3s1d/fanet-stm32/README.md

# FANET
Flying Ad-hoc Network 

# IDE
Use SW4SRTM32

# Protocol
[Brief specification](https://github.com/3s1d/fanet-stm32/blob/master/Src/fanet/radio/protocol.txt)

# Documentation
[Module (PDF)](https://github.com/3s1d/fanet-stm32/raw/master/fanet_module.pdf)
