3s1d/fanet-stm32/(threads)

Thread 3 (2018-01-06):

fanet Bodenstation

wysi, 2018-01-06:
Guten Tag

Vielen Dank, dass du/ihr/skytraxx euch dafür entschieden habt, fanet opensource zu machen.
Mir ist bekannt, dass skytraxx im Sommer einen fanet Bodenstation herausgeben wird.

Mich würde folgendes zum Thema Bodenstation interessieren:

Ist vorgesehen, dass darüber neben Wetterdaten auch die Daten von open glider net über fanet and die skytraxx Geräte gesendet werden?
Damit kann man umgehen, dass eine Mobilfunkverbindung/Wifi Hotspot benötigt wird um die Daten von Nicht-Fanet Geräten auf dem skytraxx anzuzeigen.

Ich stelle mir vor, dass ich z.B. mit einem Raspberry Pi als Bodenstation die ONG Datenbank nach Einträgen im Umkreis von einigen Kilometern scanne und die Daten von Nicht-Fanet Geräten (Reine FLARM, Segelflieger, Flugzeuge) über ein LoRa Modul und das Fanet Protokoll an die skytraxx Geräte sende.

Diese skytraxx Geräte hätten somit alle ONG Daten ohne direkt Mobilfunkverbindung/Internet auf dem Bildschirm.

3s1d, 2018-01-09:
Hallo wysi,

dein Vorschalg schwebt mir auch schon laenger im Kopf herum. Theoretisch waere es moeglich und ich wuerde das Protokoll dementsprechend erweitern wenn es umgesetzt werden soll.

Derzeit bin ich am kaempfen das Basisstationen FANET daten an OGN Server, also so wie ein Skytraxx 3.0 mit WLAN, weiterleiten. Da wir nicht alles alleine machen wollen versuche ich moeglichst viele Partner ins Boot zu holen und diese gilt es zunaechst zu ueberzeugen.

Viele Gruesse
Juergen

TL;DR: Theoretisch ja, prakitsch wird es noch etwas dauern.

Closed 2018-01-09.

Thread 4 (2018-04-26):

Beacons to OGN aprs servers

Meisterschueler, 2018-04-26:
We can see these beacons from fanet devices:

```
FNTFF00BD>OGNFNT,qAS,FNBFF00BD:/182547h3820.71N/00028.78Wg295/000/A=000043 !W74! id1FFF00BD -04fpm
FNBFF00BD>OGNFNT,TCPIP*,qAC,GLIDERN2:/182547h3820.72NI00028.78E&/A=000043
FNTFF00BD>OGNFNT,qAS,FNBFF00BD:/182547h3820.71N/00028.78Wg295/000/A=000043 !W74! id1FFF00BD +03fpm
FNTFF00BD>OGNFNT,qAS,FNBFF00BD:/182547h3820.71N/00028.78Wg295/000/A=000043 !W74! id1FFF00BD -01fpm
FNTFF00BD>OGNFNT,qAS,FNBFF00BD:/182547h3820.71N/00028.78Wg295/000/A=000043 !W74! id1FFF00BD -03fpm
FNBFF00BD>OGNFNT,TCPIP*,qAC,GLIDERN2:/182547h3820.72NI00028.78E&/A=000043
FNTFF00BD>OGNFNT,qAS,FNBFF00BD:/182547h3820.71N/00028.78Wg295/000/A=000043 !W74! id1FFF00BD +03fpm
FNTFF00BD>OGNFNT,qAS,FNBFF00BD:/182547h3820.71N/00028.78Wg295/000/A=000042 !W74! id1FFF00BD +01fpm
FNTFF00BD>OGNFNT,qAS,FNBFF00BD:/182547h3820.71N/00028.78Wg295/000/A=000042 !W74! id1FFF00BD -06fpm
FNBFF00BD>OGNFNT,TCPIP*,qAC,GLIDERN2:/182547h3820.72NI00028.78E&/A=000043
FNTFF00BD>OGNFNT,qAS,FNBFF00BD:/182547h3820.71N/00028.78Wg295/000/A=000043 !W74! id1FFF00BD -01fpm
FNTFF00BD>OGNFNT,qAS,FNBFF00BD:/182547h3820.71N/00028.78Wg295/000/A=000043 !W74! id1FFF00BD +01fpm
FNTFF00BD>OGNFNT,qAS,FNBFF00BD:/182547h3820.71N/00028.78Wg295/000/A=000043 !W74! id1FFF00BD -00fpm
FNBFF00BD>OGNFNT,TCPIP*,qAC,GLIDERN2:/182547h3820.72NI00028.78E&/A=000042
FNTFF00BD>OGNFNT,qAS,FNBFF00BD:/182547h3820.71N/00028.78Wg295/000/A=000043 !W74! id1FFF00BD +02fpm
FNTFF00BD>OGNFNT,qAS,FNBFF00BD:/182547h3820.71N/00028.78Wg295/000/A=000043 !W74! id1FFF00BD +06fpm
FNTFF00BD>OGNFNT,qAS,FNBFF00BD:/182547h3820.71N/00028.78Wg295/000/A=000043 !W74! id1FFF00BD +01fpm
FNBFF00BD>OGNFNT,TCPIP*,qAC,GLIDERN2:/182547h3820.72NI00028.78E&/A=000043
FNTFF00BD>OGNFNT,qAS,FNBFF00BD:/182547h3820.71N/00028.78Wg295/000/A=000043 !W74! id1FFF00BD -04fpm
FNTFF00BD>OGNFNT,qAS,FNBFF00BD:/182547h3820.71N/00028.78Wg295/000/A=000043 !W74! id1FFF00BD -05fpm
```

My thoughts:

1. a device should send informations only once per timestamp. Multiple beacons with same timestamp and different climb rate seems invalid. One information per timestamp means: one beacon or beacons with different types (e.g. position beacon + status beacon as the tracker does).
2. we see "two devices". The device "FNB" is a "receiver" sending beacons to GLIDERN2, the device "FNT" is the aircraft and it is received by the "FNB". Both have the same dstcall. This behaviour is distantly related to the APRS beacons for <= 0.2.6. But: the "receiver" beacon is just a subset of the "aircraft" beacon.

My idea: the FNT behaviour should be the same as the naviter beacons:

- no more FNTxxxxxx>OGNFNT,qAS,FNBxxxxxx:/blabla since it is the same device
 ... but a FNTxxxxxx>OGNFNT,qAS,GLIDERN1:/blabla --> for beacons from the "device"
 ... and FNTyyyyyy>OGNFNT,FNTxxxxxx*,qAS,GLIDERN1:/blabla --> for device yyyyyy seen and relayed by the device xxxxxx
- no more FNB beacons since they are quite useless beside the FNT beacons (correct me if I am wrong)
 ... but a FNTxxxx>OGNFNT,qAS,GLIDERN1:>blabla --> status beacon with information about the skytraxx software or something like this

3s1d, 2018-05-01:
This is not an FANET related issue. The device in question does not even have an FANET model build in (see ID FFxxxx). It's a Skytraxx 3.0 w/ WiFi. Please tell me your mail address or contact me via my Skytraxx contact.

In short:
As during the time of development there was no way to add other devices than OGN/FLARM. The 'naviter interface' was not present back than. I tried to expend the interface but nobody from OGN reacted on my request. So I botched I'net connected devices and FANET devices in! Here the base station is only emulated as it is required to get displayed on glidertracker.de (w/o a base station they do not display anything). In case of a real FANET devices it is really a flying base station which will forward any other FANET node to the OGN servers. So it's mandatory in that cases. I'd be happy to change the protocol to a suitable modern one, but i won't do it every 6month (got other things to do).

During none-flight mode the position should be reported every 20sec and the base station gets updated every 60sec. So the 3 to 1 line ratio is correct. The constant time may be a GPS-fix related bug which I have to check.

Cheers
Juergen

Closed 2018-05-01.

Thread 10 (2020-05-15):

response

z983889767, 2020-05-15:
Hello, I'm a student. I'm learning fanet recently, so I want to know what routing protocol your code adopts. If you know ，please tell me. I would be grateful

3s1d, 2020-05-27:
Hi,
as said, there is currently no routing other then a decision table based 1-hop forwarding. Well fanet-base has a geo fence based forwarding as well. However I won't call one for them routing in the classical sense.

Juergen

Thread 12 (2021-04-17):

request contact to implement fanet protocol

DRIZO, 2021-04-17:
Hello Juergen,
What is the correct way to contact with you or fanet protocol developer?
I interested on implementation of fanet protocol in our devices.
Thanks

3s1d, 2021-04-17:
Hi Drizo,

you can ask me anything here, or use my mail address:
[secondWordOfYourText-aka-myFirstName] [at] skytraxx [dot] eu

Cheers,
Juergen

Thread 14 (2022-01-07):

915Mhz Question

Tokter, 2022-01-07:
What are the plans for FANET outside of Europe?

On the Skytraxx 2.1 product page (https://en.skytraxx.eu/product-page/skytraxx-2-1) it states:

_FANET and FLARM broadcast on 868Mhz. Outside the EU, FANET must be deactivated.
The frequency is also planned to be expanded to 915Mhz for 2020._

The Skytraxx 4.0 product page does not mention anything about frequencies yet.

I know there are other vario manufacturers that use your module to provide the Fanet/Flarm functionality, which then in turn have the same limitation of only working/be legal in Europe. Without explaining that limitation as transparently on their websites.

Is there any hope for people like me that would need the 915MHz option, or is that market just too small to bother?

Thanks,
Markus

3s1d, 2022-01-23:
Hi,
well... Covid happened. We still plan to enable 9xxMhz for FANET. It's very import to us. However, due to the chip shortage and so on, we currently do not have time to figure out all the 'little' details for each country (like: frequency, power, bandwidth, duty cycle, and many more).  If you can provide a list or anything else this would greatly boost the development. Thanks,
Juergen

Tokter, 2022-01-24:
I'm not an expert in that, but I tried to gather at least some of the relevant information. Thanks for the update!

# US

## Frequency spectrum
902Mhz - 928MHz

## Bandwidth
I think you're using 250kHz, so this applies:
_if the 20 dB bandwidth of the hopping channel is 250 kHz or greater, the system shall use at least 25 hopping frequencies_

## Duty Cycle
For 250kHz bandwidth, this applies:
_the average time of occupancy on any frequency shall not be greater than 0.4 seconds within a 10 second period._

## Power
_0.25 watts for systems employing less than 50 hopping channels, but at least 25 hopping channels_

This assumes an antenna with no more than 6dBi gain:
 _The conducted output power limit specified in paragraph (b) of this section is based on the use of antennas
with directional gains that do not exceed 6 dBi. Except as shown in paragraph (c) of this section, if transmitting antennas of directional gain greater than 6 dBi are used, the conducted output power from the intentional radiator shall be reduced below the stated values in paragraphs (b)(1), (b)(2), and (b)(3) of this section, as appropriate, by the amount in dB that the
directional gain of the antenna exceeds 6 dBi_

## Links
Regulation: https://www.govinfo.gov/content/pkg/CFR-2013-title47-vol1/pdf/CFR-2013-title47-vol1-sec15-247.pdf
ISM-Band and Short Range Device Regulatory Compliance Overview: https://www.ti.com/lit/an/swra048/swra048.pdf

3s1d, 2022-02-20:
Hi,

thanks for the information. Guess I have to start somewhere...

As I recall it correctly there is some kind of threshold were one does not need to do frequency hopping, right?! I'd hate to implement this. Specially for devices w/o GPS this is not simple... (This is the only thing currently holding me back.)

Right now the duty cycle is below 1%, all antenna gains are <4dBi, and we are transmitting with 14dBm (25mW). Do I recall it correctly that we'd simple would have to increase the used bandwidth to >250kHz and then we are fine?

Can you implement the driver? Do you want to do testing, as it's not legal in my area :)
What kind of device are you using?  -> Contact me via mail.

Juergen

ifrew, 2022-03-30:
Hi Jurgen,

Hope you are doing well. This is Iain from Seattle. I worked with Phil on the Airwhere project, met with you at Kossen and have since developed my little vario and fanet device to a fully functional working prototype based on esp32. I thought i'd update the old fanet software I ported from your original code to the latest version you have here and so came across this comment. I investigated getting my device certified over here and contacted a lab that could do FCC testing in Chicago. Cost was around $10,000 so pretty spendy. However, I gleamed some good information from them. You do not need to implement frequency hopping I'm glad to report as long as you use a frequency bandwidth of 500Khz. I was surprised by this but they assured me that would be legal. They also wouldn't do frequency hopping tests for me due to the test equipment they would need to setup as the market for using that is so small. So currently I use as my parameters over here,

                sx1276.setPreambleLength(5);
		sx1276.setSignalBandwidth(500E3);
		sx1276.setSpreadingFactor(10);
		sx1276.setTimeout(5);
		sx1276.setCodingRate4(5);
		sx1276.enableCrc();
		sx1276.setSyncWord(0xF1);

These should be good for you and it would be great if you used the same parameters for the USA moving forwards. I do know that XCTracer Maxx use freq hopping and got FCC tested going down that route. If you do want to get setup in the USA then I'd be happy to help out, maybe even be your rep over here, just send me a mail.

Cheers

Iain

3s1d, 2024-01-26:
Hi iFrew,

I fully missed your posed for years... SORRY!
Meanwhile we have defined non EU frequencies. Please see fmac.h.
Did you stick to 916Mhz or maybe have you moved the frequency? We should find a common base somehow (thou' the software is already rolled out to thousends of devices)...

Bests,
Juergen

ifrew, 2024-01-26:
Not a problem Juergen.

I don't have as many devices as you. We exchanged email about this relatively recently directly and I know the frequencies you changed. I don't have thousands of devices but enough for me not to change it. My device is only used locally by pilots here in the NW USA anyway as they were mainly prototypes. Have you got a lot of them now being used in the USA?

Cheers

Iain

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

3s1d, 2024-08-01:
Fanet new supports 9xxMhz freq outside of the EU.

Closed 2024-08-01.

Thread 20 (2025-02-26):

[feature request] FANET protocol specs do not cover 2.4 GHz LoRa band at this time

lyusupov, 2025-02-26:
Some of Semtech radios, such as SX1280 and LR112X series are able to operate over 2.4 GHz ISM band.

Current FANET protocol specs https://github.com/3s1d/fanet-stm32/blob/master/Src/fanet/radio/protocol.txt
have no data associated with the 2.4 GHz band.

Would be nice to see an update of the FANET specs with freq/bw/sf/power/dc/... plan(s) for the 2.4 GHz band.

Hilbren, 2025-02-26:
However, and it is a big however, there are several drawbacks. To begin with, 2.4 GHz is an absorption band of water, which is why your microwave operates at this frequency. Water and water vapor convert this frequency into heat. Incidentally, WiFi also operates at this frequency. The advantage here is that each house can create its own small bubble with sufficient data transmission. A few houses further on, the air has absorbed everything, and new WiFi networks can be set up in the air with the same frequency. For Fanet, you actually want the opposite—an enormous range without the energy being absorbed. You also do not want to be disturbed by WiFi networks or microwaves. In other words, 2.4 GHz does not seem very suitable for Fanet to me.

3s1d, 2025-02-26:
Hi everyone,

FLARM is completely independent from FANET and vice versa. It just happens that both are used in aviation. Well, FANET was born as FLARM is a closes protocol and I wanted to take advantage of next gen PHY layer in order to maximise range.
Thou' I have very good contacts to FLARM :) We did develop ADS-L together.

I don't understand why one should move to 2.4Ghz and nuke 60000 units into obsolence, for on good reason? The throughput is carefully chosen so that the bandwidth will not be hit even in the heave tailed paragliding scenarios. Without compromising the range. It's not like: 'I think this is cool, let's do it...' I made extensive simulations for various scenarios and the result was FANET with its really good range and stability.

So if you don't have any good reason why one should use 2.4Ghz other then 'because it MAY be cool', I reject your approach and stick to the 60000 users who can continue using there devices.

Cheers,
Juergen

Hilbren, 2025-02-26:
FLARM independent from FANET, didn't knew that, cool! and thx!
The rest of the answer also sounds logical.

lyusupov, 2025-02-26:
@3s1d  please, show any place in my previous messages where I suggest you to transfer FANET from 868 MHz to 2.4 GHz...

There are 7 regions specified here: https://github.com/3s1d/fanet-stm32/blob/master/Src/fanet/radio/protocol.txt#L23-L63

* "US920",
* "AU920",
* "IN866",
* "KR923",
* "AS920",
* "IL918",
* "EU868",

What is wrong to add one more region in the specs that would define one world global 2.4 GHz setting ?

3s1d, 2025-02-26:
First tell me why you want to separate the network? What is your motivation? There is plenty of bandwidth and the system works. If you are in the EU, you use EU868 and in America US920. Everybody is doing the same and everybody can communicate with each other.

If I would accept a 2.4Ghz, what do you pick? In EU: EU868 or 2.4GHz? And why, based on which metric? Effectively forming 2 incompatible networks which can not communicate between each other -> i consider this very bad! Why should we do this??? Just give me one reason? Streaming Video/Audio is not the use case and highly doubt that would even be feasible.

Sure I could do, but I would mark it as DO NOT USE or something like that.

lyusupov, 2025-02-26:
> why you want to separate the network? What is your motivation?

Semtech is pushing LoRa to use 2.4 Ghz band is the future
SX1280 is the fist IC that can do Lora @ 2.4 GHz  but is has no sub-!GHz radio at all.
Any of currently defined FANET regions are not applicable for SX1280.

> Effectively forming 2 incompatible networks which can not communicate between each other

Expansion of a protocol beyond  current 860-960 limits is inevitable.
For example, in China, AFAIK they can not legally use 860-960 MHz band.
Sooner or later you will have to define a FANET region in 430-470 MHz band to use it in China as well.

> Sure I could do, but I would mark it as DO NOT USE or something like that.

It is already written there as:  " Work in progress: "
https://github.com/3s1d/fanet-stm32/blob/master/Src/fanet/radio/protocol.txt#L23

3s1d, 2025-02-27:
China uses 779-787Mhz. I can add this if you want.

The highest 2 goals are:
- keep everyone compatible (not separating the network)
- maximising range

2.4Ghz violates both, for no reason. Because the chip exists does not mean you have to use it.
The Chip exists since 2017 and i decided already against 2.4Ghz as I do not see any benefits for the application, only drawbacks.

Further, FLARM, ADS-L are all on SubGhz that would mean that we have to put 2 transceivers into our devices???

TL;DR provide 1 good reason why we should use it.

Closed 2025-02-26.

Thread 23 (2025-03-15):

Question about the codo and FANET protocol during forwarding.

rvt, 2025-03-15:
Hey,

when I look at this line : https://github.com/3s1d/fanet-stm32/blob/master/Src/fanet/radio/fmac.cpp#L520

I see the condition `!frm->ack_requested || frm->src != myAddr`

I understand that we delete the frame if the two conditions are met:

1. Frame requires ack
2. Frame with source not our own

Unless we receive a frame with our own source address that is forwarded two hopp?? we always delete the frame.

Under what condition would we not delete frame and keep it in the queue, is this just for our own frames that where never acked and coming back somehow?

Cheers,
Ries

3s1d, 2025-03-17:
Hi Ries,

I think there might be a misunderstanding?! The cited code is inside the transmission process and is located after the successful transmission. And only then we remove the packet if ONE of any conditions is met (or || not and &&):

1) If it does NOT (!) require an ACK, nobody will respond to it on the lowest layer.
or
2) We are not the source, ie. we forwarded it frame only.

If not deleted it will be in the pool for the next transmission round. And should get handled sooner or later.

Should be alright?

Cheers,
Juergen

Thread 24 (2025-03-27):

Barometric pressure calculation for type 4 division by 10 or by 100??

rvt, 2025-03-27:
Closing: I just found you also have a separate code base for a base station that shows the 10x

Hey,

I was looking at the calculation for Barometric pressure here where the division is shown at 10 : https://github.com/3s1d/fanet-stm32/blob/master/Src/fanet/radio/protocol.txt#L183

When I do the math for min/max it seems to be fitting better for a range of `430-1085.34` when the division is by 100 instead of 10

`(1085.35-430)*100 = 65535 == 0xFFFF`

Division by 100 fit's better within the 16bit uint instead of by 10 so I was wondering of the documentation was in error?

When looking on the net for different implementations I have seen both used...

Note: 1,084.8 hPa was the highest ever record in Tosontsengel, Mongolia on 19 December 2007 which made me thing this was may be a typo in protocol.txt

Closed 2025-03-27.
