3s1d/fanet-stm32/module/internal-v2.brd

## EAGLE design module/internal-v2.brd (2025-12-01)

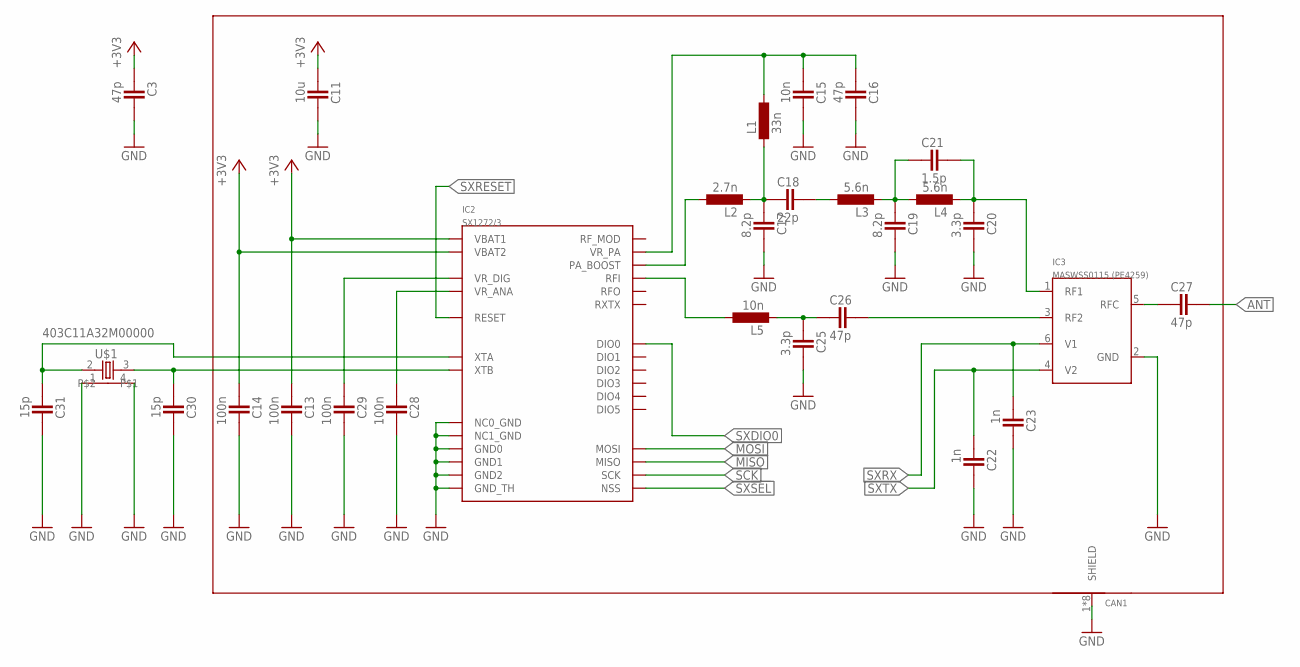
[picture p5: schematic internal-v2.sch, sheet 1]

Parts:
C3, C16, C26, C27: 47p; CAPC1005X60N
C11: 10u; CAPC2012X145AN
C13, C14, C28, C29: 100n; CAPC1005X60N
C15: 10n; CAPC1005X60N
C17, C19: 8.2p; CAPC1005X60N
C18: 22p; CAPC1005X60N
C20, C25: 3.3p; CAPC1005X60N
C21: 1.5p; CAPC1005X60N
C22, C23: 1n; CAPC1005X60N
C30, C31: 15p; CAPC1005X60N
CAN1: RF-SHIELD; RF-SHIELDING-13.66X12.70
IC2: SX1272/3; QFN28
IC3: MASWSS0115 (PE4259); SC-70
L1: 33n; INDC1005X60N
L2: 2.7n; INDC1005X60N
L3, L4: 5.6n; INDC1005X60N
L5: 10n; INDC1005X60N
U$1: 403C11A32M00000; MT

Connections:
+3V3: C3.1, C11.1, C13.1, C14.1, IC2.P$1 (VBAT1), IC2.P$15 (VBAT2); also elsewhere on the board
ANT: C27.2
GND: C3.2, C11.2, C13.2, C14.2, C15.2, C16.2, C17.2, C19.2, C20.2, C22.2, C23.2, C25.2, C28.2, C29.2, C30.2, C31.2, CAN1.1, CAN1.2, CAN1.3, CAN1.4, CAN1.5, CAN1.6, CAN1.7, CAN1.8, IC2.P$7 (NC0_GND), IC2.P$8 (NC1_GND), IC2.P$16 (GND0), IC2.P$22 (GND1), IC2.P$26 (GND2), IC2.P$29 (GND_TH), IC3.2 (GND), U$1.1, U$1.4; also elsewhere on the board
MISO: IC2.P$18 (MISO); also elsewhere on the board
MOSI: IC2.P$19 (MOSI); also elsewhere on the board
unnamed: IC2.P$27 (PA_BOOST), L2.2
unnamed: C17.1, C18.1, L1.1, L2.1
unnamed: C15.1, C16.1, IC2.P$28 (VR_PA), L1.2
unnamed: C18.2, L3.2
unnamed: C19.1, C21.1, L3.1, L4.2
unnamed: C27.1, IC3.5 (RFC)
unnamed: C20.1, C21.2, IC3.1 (RF1), L4.1
unnamed: IC2.P$25 (RFI), L5.2
unnamed: C25.1, C26.1, L5.1
unnamed: C26.2, IC3.3 (RF2)
unnamed: C28.1, IC2.P$2 (VR_ANA)
unnamed: C29.1, IC2.P$3 (VR_DIG)
unnamed: C30.1, IC2.P$5 (XTB), U$1.3 (2)
unnamed: C31.1, IC2.P$4 (XTA), U$1.2 (1)
SCK: IC2.P$17 (SCK); also elsewhere on the board
SX!SEL: IC2.P$20 (NSS); also elsewhere on the board
SXDIO0: IC2.P$9 (DIO0); also elsewhere on the board
SXRESET: IC2.P$6 (RESET); also elsewhere on the board
SXRX: C23.1, IC3.6 (V1); also elsewhere on the board
SXTX: C22.1, IC3.4 (V2); also elsewhere on the board

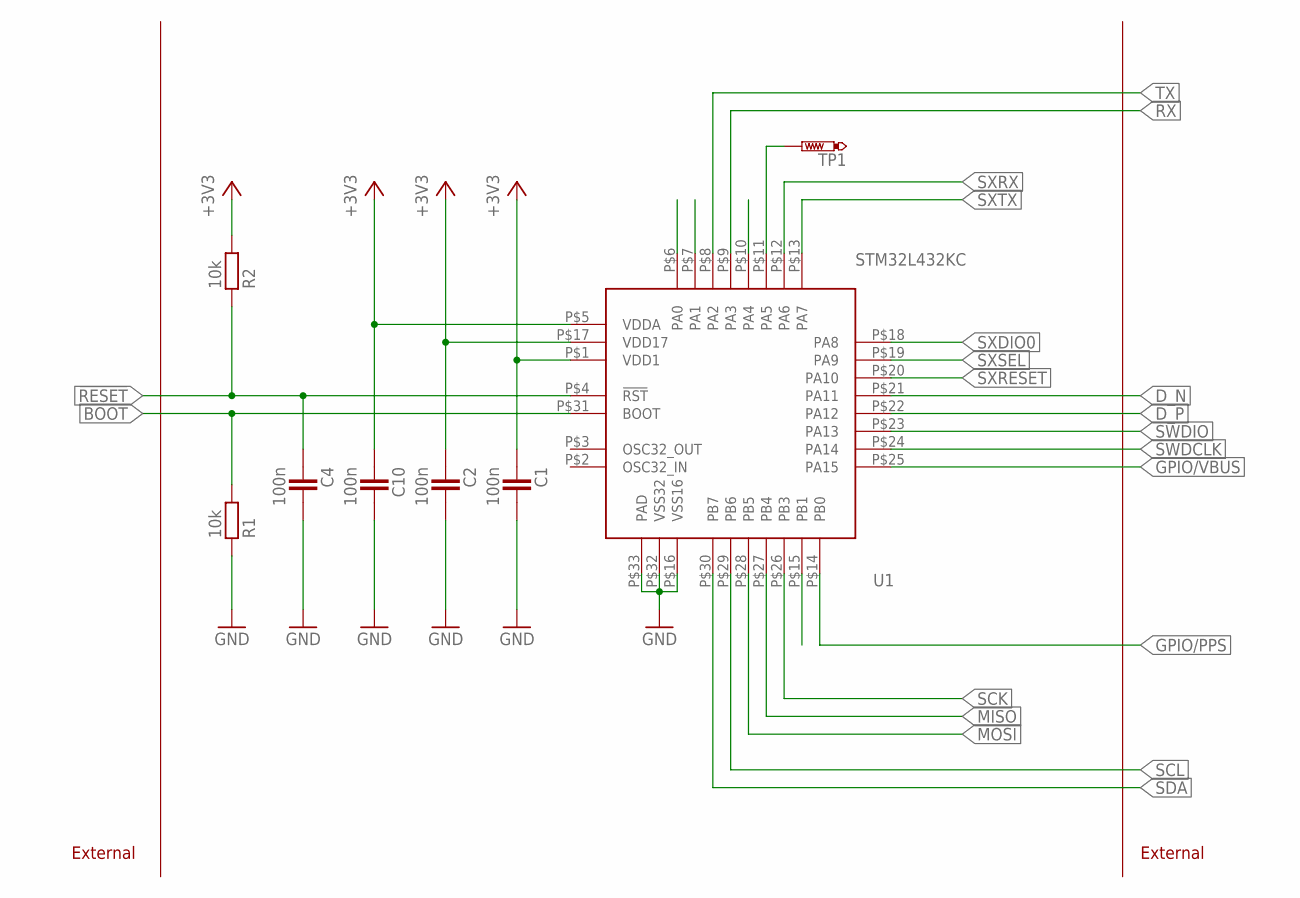
[picture p6: schematic internal-v2.sch, sheet 2]

Parts:
C1, C2, C4, C10: 100n; CAPC1005X60N
R1, R2: 10k; RESC1005X40AN
TP1: PTR1TP06R; TP06R
U1: STM32L432KC

Connections:
!RESET: C4.1, R2.1, U1.P$4 (!RST)
+3V3: C1.1, C2.1, C10.1, R2.2, U1.P$1 (VDD1), U1.P$5 (VDDA), U1.P$17 (VDD17); also elsewhere on the board
A0: U1.P$10 (PA4)
A1: TP1.TP, U1.P$11 (PA5)
A2: U1.P$6 (PA0)
A4: U1.P$15 (PB1)
BOOT: R1.2, U1.P$31 (BOOT)
D13: U1.P$7 (PA1)
D_N: U1.P$21 (PA11)
D_P: U1.P$22 (PA12)
GND: C1.2, C2.2, C4.2, C10.2, R1.1, U1.P$16 (VSS16), U1.P$32 (VSS32), U1.P$33 (PAD); also elsewhere on the board
GPIO/PPS: U1.P$14 (PB0)
GPIO/VBUS: U1.P$25 (PA15)
MISO: U1.P$27 (PB4); also elsewhere on the board
MOSI: U1.P$28 (PB5); also elsewhere on the board
RX: U1.P$9 (PA3)
SCK: U1.P$26 (PB3); also elsewhere on the board
SCL: U1.P$29 (PB6)
SDA: U1.P$30 (PB7)
SWDCLK: U1.P$24 (PA14)
SWDIO: U1.P$23 (PA13)
SX!SEL: U1.P$19 (PA9); also elsewhere on the board
SXDIO0: U1.P$18 (PA8); also elsewhere on the board
SXRESET: U1.P$20 (PA10); also elsewhere on the board
SXRX: U1.P$12 (PA6); also elsewhere on the board
SXTX: U1.P$13 (PA7); also elsewhere on the board
TX: U1.P$8 (PA2)

Notes on the sheet:
External

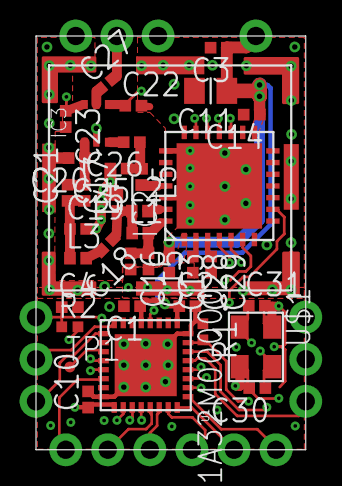
[picture p7: board internal-v2.brd from above]

Board: 4 copper layers, 15.0 x 23.0 mm, 37 parts (0 on the bottom side), 27 nets.
