3s1d/fanet-stm32/Src/main.c

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

/* Includes ------------------------------------------------------------------*/
#include "main.h"
#include "dma.h"
#include "usart.h"
#include "spi.h"
#include "gpio.h"

/* USER CODE BEGIN Includes */

#include <stdio.h>
#include <stdbool.h>
#include <string.h>							//TBR!!!
#include <math.h>

#include "config.h"

#include "bootloader/bld_upd.h"
#include "fanet/fanet.h"
#include "fanet/radio/sx1272.h"
#include "fanet/wire/serial.h"

//  ../bootloader/xload-imgbuilder/Release/xload-imgbuilder Release/fanet.elf 5 dongle

/* USER CODE END Includes */


/* USER CODE BEGIN PV */
bool initialized = false;

/* USER CODE END PV */

void SystemClock_Config(void);
/* USER CODE BEGIN PFP */
#ifdef DEBUG
extern void initialise_monitor_handles(void);
#endif

/* USER CODE END PFP */

/* USER CODE BEGIN 0 */

/* EXTI wrapper */
void HAL_GPIO_EXTI_Callback(uint16_t GPIO_Pin)
{
	if (!initialized)
		return;

	if (GPIO_Pin == SXDIO0_EXTI8_Pin)
		fanet_sx_int();

	if (GPIO_Pin == GPIO_PPS_EXTI0_Pin)
		fanet_pps_int();
}

/* USER CODE END 0 */

/**
  * @brief  The application entry point.
  * @retval int
  */
int main(void)
{
  /* MCU Configuration--------------------------------------------------------*/

  /* Reset of all peripherals, Initializes the Flash interface and the Systick. */
  HAL_Init();

  /* Configure the system clock */
  SystemClock_Config();

  /* Initialize all configured peripherals */
  MX_GPIO_Init();
  MX_DMA_Init();
  MX_LPUART1_UART_Init();
  MX_SPI3_Init();
  /* USER CODE BEGIN 2 */

	/* Debug */
#ifdef DEBUG
	/* semihosting */
//	initialise_monitor_handles();

	printf("### DEBUG Enabled\n");
#endif

	/* initialize serial */
	serial_t *serial = serial_init(HAL_UART_get());

#if 0
	/*
	 * WARNING this removes the read out protection and kills the bootloader!
	 */
	FLASH_OBProgramInitTypeDef obProgram = {0};
	obProgram.OptionType = OPTIONBYTE_RDP;
	obProgram.RDPLevel = OB_RDP_LEVEL_0;
	HAL_FLASH_Unlock();
	HAL_FLASH_OB_Unlock();
	HAL_FLASHEx_OBProgram(&obProgram);
	HAL_FLASH_OB_Launch();
	HAL_FLASH_OB_Lock();
	HAL_FLASH_Lock();
#endif

#ifdef UPDATE_BOOTLOADER
	bootloader_update(serial->uart);				//duration 10-250ms
#endif

	fanet_init(serial);

	initialized = true;

  /* USER CODE END 2 */

  /* Infinite loop */
  /* USER CODE BEGIN WHILE */
	while (1)
	{
		fanet_loop();

    /* USER CODE END WHILE */

    /* USER CODE BEGIN 3 */

	}
  /* USER CODE END 3 */
}

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
