3s1d/fanet-stm32/fanet.ioc

Mcu.UserName=STM32L432KCUx
PB0.GPIO_Label=GPIO_PPS_EXTI0
PA6.GPIO_Label=SXRX
PA10.GPIO_Label=SXRESET
PA8.Signal=GPXTI8
PA6.Signal=GPIO_Output
PA10.Signal=GPIO_Output
PA3.Signal=LPUART1_RX
PA9.GPIO_Label=SXSEL
PA8.GPIO_Label=SXDIO0_EXTI8
PA9.Signal=GPIO_Output
PA5.Signal=GPIO_Output
PA2.Signal=LPUART1_TX
PB5.Signal=SPI3_MOSI
PA7.GPIO_Label=SXTX
PA5.GPIO_Label=TP1
PB0.Signal=GPXTI0
PA7.Signal=GPIO_Output
