3s1d/fanet-stm32/Inc/main.h

#define TP1_Pin GPIO_PIN_5
#define TP1_GPIO_Port GPIOA
#define SXRX_Pin GPIO_PIN_6
#define SXRX_GPIO_Port GPIOA
#define SXTX_Pin GPIO_PIN_7
#define SXTX_GPIO_Port GPIOA
#define GPIO_PPS_EXTI0_Pin GPIO_PIN_0
#define GPIO_PPS_EXTI0_GPIO_Port GPIOB
#define GPIO_PPS_EXTI0_EXTI_IRQn EXTI0_IRQn
#define SXDIO0_EXTI8_Pin GPIO_PIN_8
#define SXDIO0_EXTI8_GPIO_Port GPIOA
#define SXDIO0_EXTI8_EXTI_IRQn EXTI9_5_IRQn
#define SXSEL_Pin GPIO_PIN_9
#define SXSEL_GPIO_Port GPIOA
#define SXRESET_Pin GPIO_PIN_10
#define SXRESET_GPIO_Port GPIOA
