3s1d/fanet-stm32/(commit log)

2017-05-21 sx1272 working
    [fanet Debug semihosting.cfg, fanet.cfg]
2017-05-22 fanet working w/o arduino
2017-05-23 fixed blocking uart
2017-06-05 proper debug scheme
    [fanet Debug.cfg]
2017-06-05 large packages (>32bytes payload) could potentially have blocked the hole network by blocking athe transmitter. fixed
    [fmac.cpp, fmac.h, sx1272.c, sx1272.h]
2017-09-17 bumped to 1.9.0 and removed unneeded buses like USB and I2C
2017-09-17 adjusted frq source to compensate thermal drift
    [fanet.ioc, main.c, serial_interface.cpp]
2018-09-29 FANET 1.1
    -code cleanup
    -ground tracking
    -improved landmark interface
    [fanet Debug semihosting.cfg]
2018-11-15 added softrf manufacturer
    [fanet Debug.cfg]
2018-11-15 added state of charge for base statinos
2019-06-15 compressed coordinates sample code
2019-07-30 Forwarding bugfix for ACK'ed frames...
    [fmac.cpp]
2019-08-16 removed unstable us delay
    [fanet Release.cfg]
2019-08-20 bootloader updater added
    [fanet Debug.cfg]
2020-03-21 serial dma circular buffer fix, casw schedluing
    [app.cpp, app.h, fanet.cpp, fanet.ioc, fmac.cpp, fmac.h, serial.c, serial.h]
2020-08-03 added flarm addr issue error msg
    [fanet.cpp, serial_interface.h]
2021-09-15 tx/rx switch for fsk
2022-01-13 sx1272 driver state fixes
    [sx1272.c]
2022-01-14 XC Tracer Manufacturer Range
2022-12-06 fanet zones + sx reset
    [app.cpp, app.h, fmac.cpp, fmac.h]
2022-12-11 sx1272 crc issue fixed
    [main.c, serial_interface.cpp, sx1272.c, sx1272.h]
2023-08-28 Adds Cloudbuddy manufacturer IDs
    Adds manufacturer for Cloudbuddy gateways as well as Cloudbuddy wind sensors
2024-04-21 new device id
2024-07-29 Update protocol.txt - add new manufacturer ID for BlyBeeper devices
2025-12-01 layout added
    [internal-v2.brd, internal-v2.sch]
2026-09-03 new device
